TelosNox/noxmatic/KiCad/Schematic.PNG

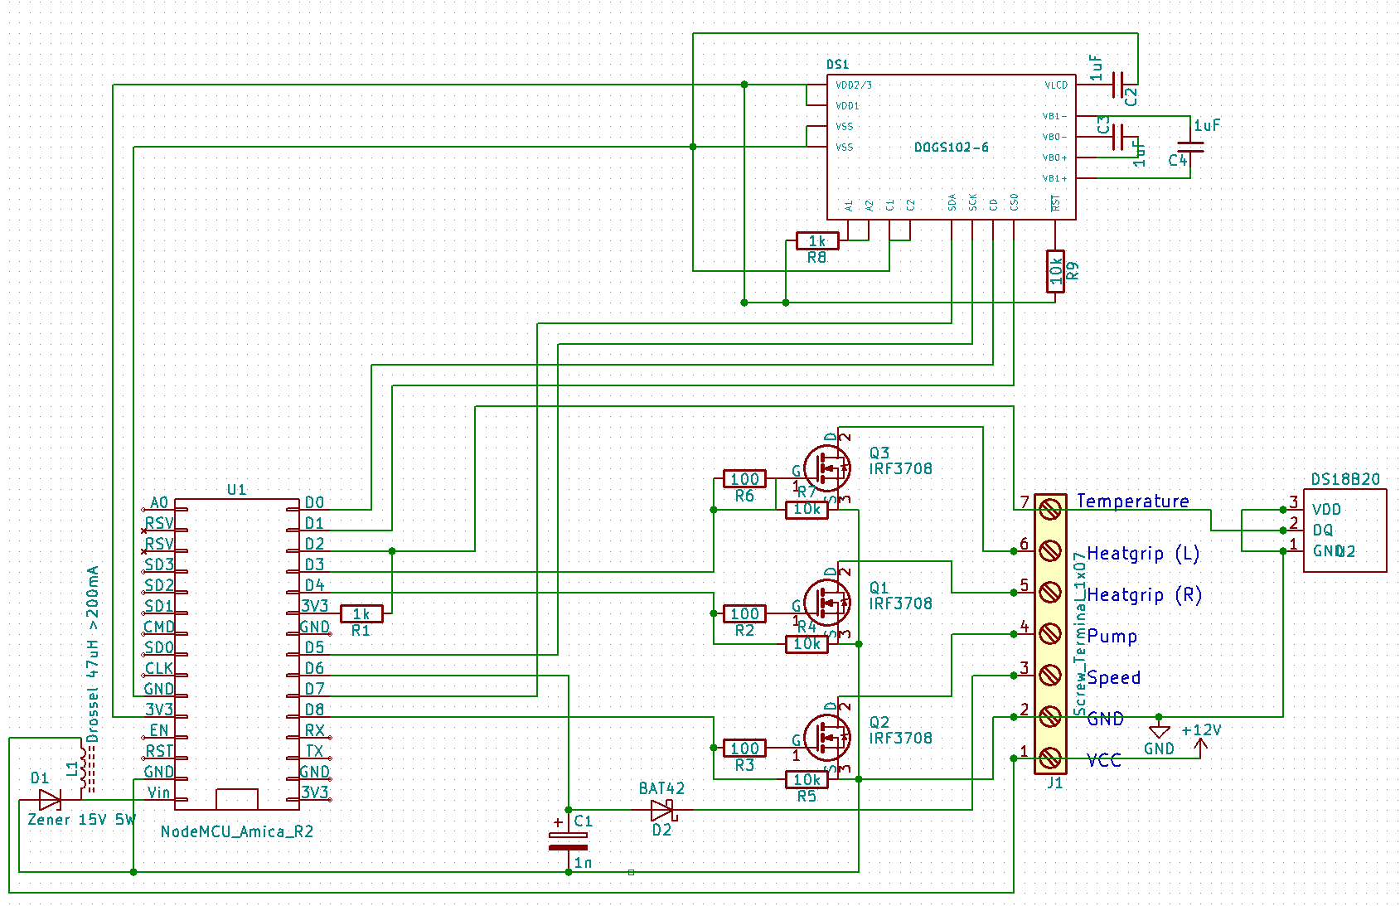
KiCad/Schematic.PNG
