TelosNox/noxmatic/KiCad/Schematic_oiler_only.pdf

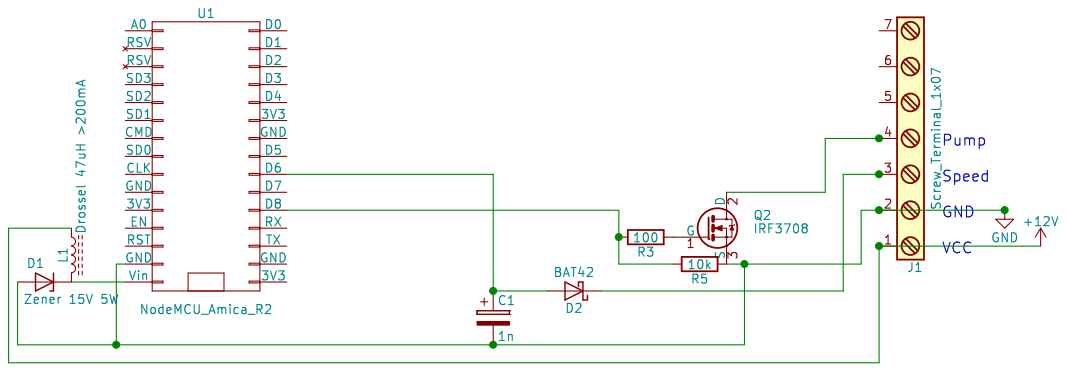
[picture p2: page 1]
