TelosNox/noxmatic/(threads)

Thread 1 (2020-02-15):

Node MCU keine Verbindung

MasterOfPuppets111, 2020-02-15:
Hallo, tolles Projekt.

Habe mal ein NODEMCU Board aus der Bastelkiste gekramt, und deinen noxmatic Sketch hoch geladen, da ich mir den Werbserver mal anschauen wollte.

Leider bekomme ich keine Verbindung zum Board.

TelosNox, 2023-12-27:
Oha, ich hab den request leider nie bemerkt. War auch ewig nicht aktiv.
Der Webserver ist so gemacht, dass man am Handy einen Hotspot bereitstellt mit den angegebenen ssid und Passwort. Wenn der Controller dieses WLAN findet, dann geht er in den Webserver Modus und sollte dann erreichbar sein
