TelosNox/noxmatic/Arduino/sketches/noxmatic/Information.h

#ifndef INFORMATION_H_
#define INFORMATION_H_

class Information {
public:
  int speed;
  int distancePercent;
  int temperature;
  int heaterPower;
  bool pumpPending;
  bool speedSignalLost;
};
#endif /* INFORMATION_H_ */
