TelosNox/noxmatic/(commit log)

2017-04-18 Share Schematics
    [Noxmatic.kicad_pcb, Noxmatic.sch]
2017-04-19 Schaltplan fix
    [Noxmatic.sch]
2017-04-19 Migration für Arduino IDE und Wechsel von U8Glib zu U8G2
2017-04-20 Settings aufräumen und alte Kommunikation entfernen
2017-04-26 Fix divisions by zero for not configured eeprom default values + get Display working
    [noxmatic.ino]
2017-04-26 Anpassung des Pullup für den DS18B20 (läuft sonst auf NodeMcu nicht)
    [Noxmatic.sch]
2017-04-29 Fix Reboots durch Interrupt + Widerstand am Display festgelegt
    [Noxmatic.sch]
2017-05-01 Abhängigkeit zwischen Display und den Modulen lösen
2017-05-08 Extraktion der Pumpenlogik aus dem Kettenöler
2017-05-08 Extract PWM from heater
2017-05-08 Direktsteuerung der Pumpe über WiFi
2017-05-22 Temperatur init + Startup Display
2017-05-25 Add Windchill to heater calculation and remove testadaption of temperature
2018-09-20 Schaltplan korrektur
    Fehlende Masseleitung eingefügt. PDF durch PNG ersetzt
    [Noxmatic.sch]
